Dfinitski/ATU-10-10W-QRP-antenna-tuner/ATU-10_Layout.pdf

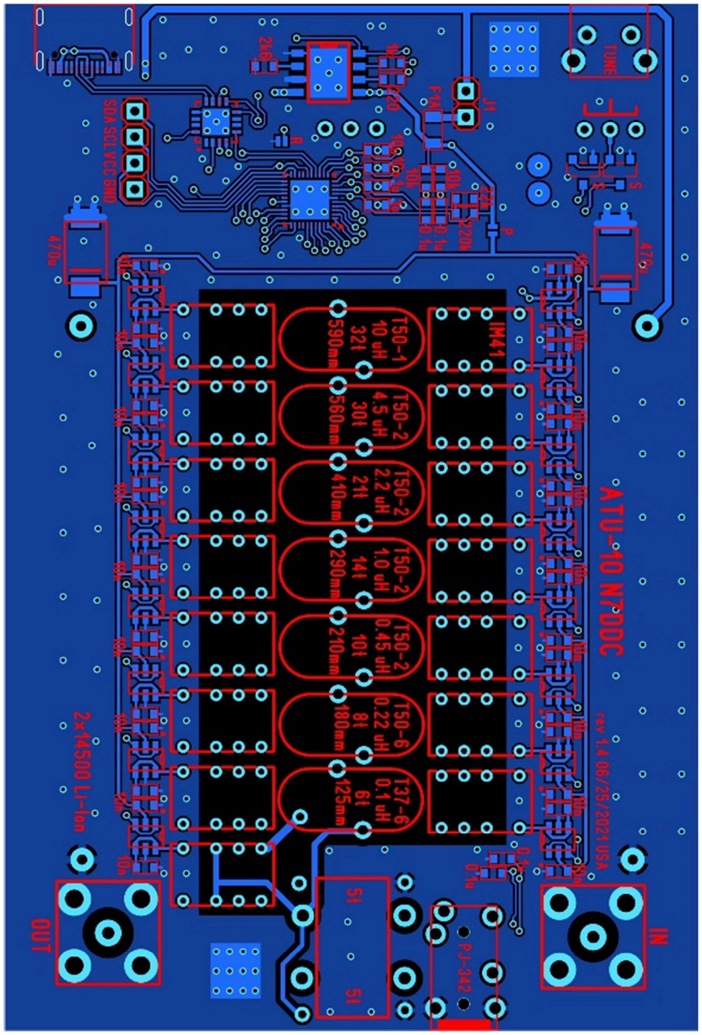
[picture p5: page 1]
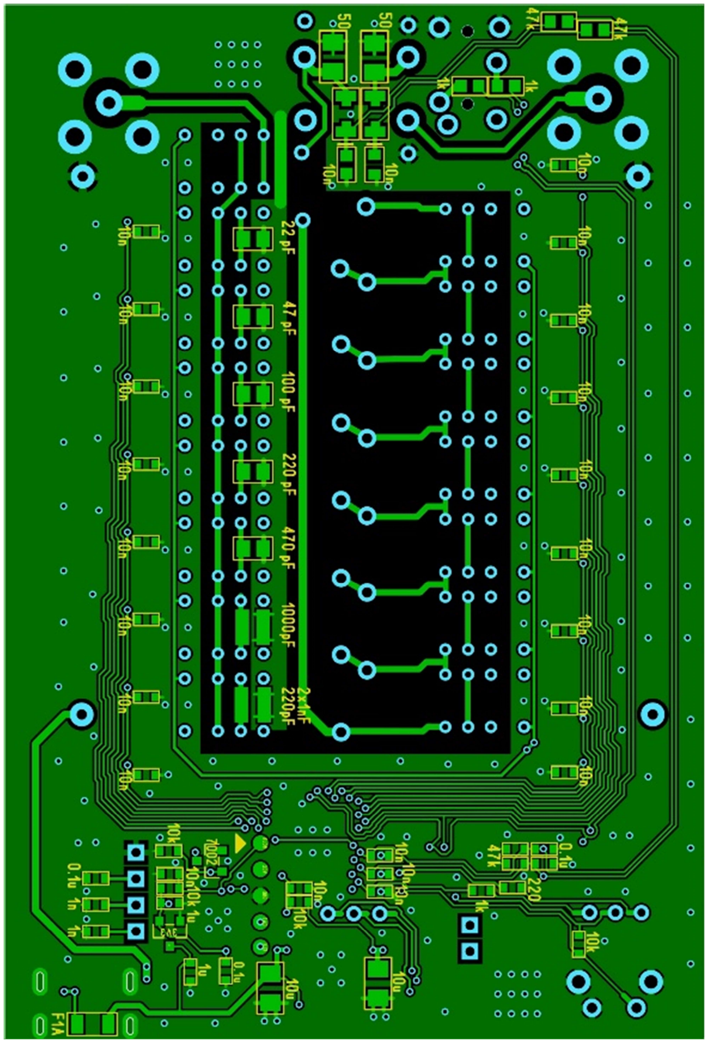
[picture p6: page 2]
