Dfinitski/ATU-10-10W-QRP-antenna-tuner/ATU-10_BOM.docx

Mosfet array 15pcs | AO6604 AO6608 SI3590DV-T1-E3 | 785-1078-1-ND 785-1078-1-ND SI3590DV-T1-E3CT-ND
Relay 15pcs | PB2007CT-ND AGN21003 IM41 G6KU-2F-Y DC3 | Z5232-ND 255-1855-ND Ebay (https://www.ebay.com/itm/163033749512) Z3030-ND
Protection diode 2pcs | BAT54SHMT116 | 846-BAT54SHMT116CT-ND
Ind core T37-6 | | Amidon (https://kitsandparts.com/toroids.php)
Ind core T50-6 | | Amidon (https://kitsandparts.com/toroids.php)
Ind core T50-2 4pcs | | Amidon (https://kitsandparts.com/toroids.php)
Ind core T50-1 | | Amidon (https://kitsandparts.com/toroids.php)
Magnet wire | 26AWG | remington_industries (http://www.ebay.com/usr/remington_industries)
Tandem match core | BN43-1502 | Amidon
RF detector 2pcs | TMMBAT41FILM | 497-7669-1-ND
MCU | PIC16F18877-E/MV | PIC16F18877-E/MV-ND
BNC connector | | Aliexpress (https://a.aliexpress.com/_vbC5ip)
PMIC 3.3V | MCP1700T-3302E/TT AP2125N-3.3TRG1 AP2138N-3.3TRG1 | MCP1700T3302ETTCT-ND AP2125N-3.3TRG1DICT-ND AP2138N-3.3TRG1DICT-ND
USB loader chip | PIC16F1454-I/ML | PIC16F1454-I/ML-ND
USB connector | USB4105-GF-A | 2073-USB4105-GF-ACT-ND
Fuse USB 1A 6V PTC | 0ZCJ0100FF2E | 507-1806-1-ND
Fuse Batt 1.25 A Fast | C1F 1.25 | 507-1879-1-ND
Func button | EVQ-PF106K | P10883S-ND
Mosfet | 2n7002
OLED 0.91 128x32 I2C | *optional | Ebay link (https://www.ebay.com/itm/0-91-inch-128x32-IIC-I2C-Blue-OLED-Display-Module-DC3-3V-5V-128-32-Arduino/254325164538)
LED Com Anode R/G 2pcs | *optional
TP4056 charger | | Ebay link (https://www.ebay.com/itm/5pcs-5V-Micro-USB-1A-18650-Lithium-Battery-Charging-Board-Charger-Module-TP4056/113789436590)
Housing | | Ebay link (https://www.ebay.com/itm/Black-Aluminum-Project-Box-Enclosure-Case-Electronic-DIY-100x71x25mm/402638686437)
14500 Battery 2pcs | | Ebay link (https://www.ebay.com/itm/353022611611?hash=item5231c9909b:g:NS8AAOSwHoFXvRWb)
M4 knurled nut 2pcs | | Ebay link (https://www.ebay.com/itm/112748150292?var=414552620773)
3.5mm audio conn | PJ-342, 311D | Aliexpress

High voltage capacitors 0805

22pF | 600F220JT250XT | 1284-1353-1-ND
47pF | 600F470JT250XT | 1284-1062-1-ND
100pF | 600F101GT250XT | 1284-1860-1-ND
220pF 2pcs | VJ0805D221KXPAJ | 720-1347-1-ND
470pF | C0805C471JCGACAUTO | 399-15869-1-ND
1000pF 3pcs | C2012C0G2W102J060AA | 445-15299-1-ND

Capacitors

10nF 50V 0603 58pcs
0.1uF 25V 0603 9pcs
1uF 10V 0603 3pcs
470uF x 6.3V tant 2pcs | T495D477K006ATE100 | 399-4701-1-ND

Resistors

49Ohm 1206 2pcs
220 Ohm 0603 2pcs
10 kOhm 5pcs
22 kOhm
220 kOhm
47 kOhm 0603 4pcs
1 kOhm 0603 4pcs
2.6 kOhm 0603
