Dfinitski/ATU-10-10W-QRP-antenna-tuner/(threads)

Thread 2 (2021-10-04):

Schematics missing

cruftex, 2021-10-04:
Many thanks for the great project! I am putting together a compact and portable rig. That is what I was missing.

Can please add the schematics? I'd like to understand how this works. Also its not clear what the EXT connector is.
Maybe external power, maybe the ICOM interface.

Dfinitski, 2021-10-04:
Hi
I did not draw a schematic, probably somebody did it , I don't know.
That is IC 705 interface.

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

Thread 5 (2022-12-16):

Data on OLED Display is getting corrupted over time.

PD5DJ, 2022-12-16:

Dfinitski, 2022-12-16:
Hi.
Yes, my tuners OLED does it too.
At this moment I guess bad displays from China make trouble because my other device do same thing and I forced to change the display

PD5DJ, 2022-12-17:
Hmm ok..

I have some older OLED's i will try and swap them out and let you know the result.

PD5DJ, 2022-12-18:
You where right!, replacing the OLED "fixed" this issue.
So the supplied OLED's with the ATU-10 are really bad. hmm

Other question, what is the reason you have set the:
`#define Delay_I2C Delay_us(25)`
To 25uS?

Dfinitski, 2022-12-18:
Hi.
It makes the bus speed about 20 kHZ

Thread 9 (2024-05-01):

Feature request: show LC setting on the screen

chinasaur, 2024-05-01:
It would be really nice to see what L and C the tuning landed on, like is shown for ATU-100.

When there is no transmit, showing the PWR=0.0 isn't very useful, so if space is an issue I'd suggest showing L and C there instead. The PWR value could be shown instead only when transmitting. The battery indicator also isn't needed all the time.
