Dfinitski/ATU-10-10W-QRP-antenna-tuner/(list of files, drawings)

Other design files:
ATU-10.lay6
PCB/ATU-10.lay6
