Dfinitski/ATU-10-10W-QRP-antenna-tuner/Firmware/ATU-10_FW_16/pic_init.c

// pic_init unit for Micro C PRO
// 2020

void pic_init (void) {
// ports initialisation
  ANSELA = 0;         // all as digital
  ANSELB = 0;         // all as digital
  ANSB0_bit = 1;      // analog input
  ANSB1_bit = 1;      // analog input
  ANSB2_bit = 1;      // analog input
  ANSELC = 0;         // all as digital
  ANSELE = 0;         // all as digital
  ANSELD = 0;         // all as digital

  C1ON_bit = 0;      // Disable comparators
  C2ON_bit = 0;

  PORTA = 0;
  PORTB = 0;
  PORTC = 0;
  PORTD = 0;
  PORTE = 0;
  LATA = 0b00000000;
  LATB = 0b00000000;
  LATC = 0b00010000;
  LATD = 0b00000110;
  LATE = 0b00000000;
  TRISA = 0b00000000;
  TRISB = 0b00100111;
  TRISC = 0b00000000;
  TRISD = 0b00000000;
  TRISE = 0b00000000;

  // open drains
  ODCA2_bit = 1;
  ODCA3_bit = 1;
  ODCD1_bit = 1;
  ODCD2_bit = 1;
  
  // Timer0 settings
  T0CS0_bit = 0; // Fosc/4
  T0CS1_bit = 1;
  T0CS2_bit = 0;
  T016BIT_bit = 1;
  TMR0L = 0xC0;   // 8_000 cycles to OF
  TMR0H = 0xE0;
  TMR0IF_bit = 0;
  T0EN_bit = 1;
  TMR0IE_bit = 1;
  
  // Modules disable
  PMD0 = 0b00011110; //
  PMD1 = 0b11111110;
  PMD2 = 0b01000111;
  PMD3 = 0b01111111;
  PMD4 = 0b1110111;
  PMD5 = 0b11011111;
  //interrupt setting
  GIE_bit = 1;
  Delay_ms (100);
  return;
}
